ManiacalLabs/Super7Seg/kicad/Super7Controller/Super7Controller.kicad_pcb

## KiCad design kicad/Super7Controller/Super7Controller.kicad_pcb (2017-02-23)

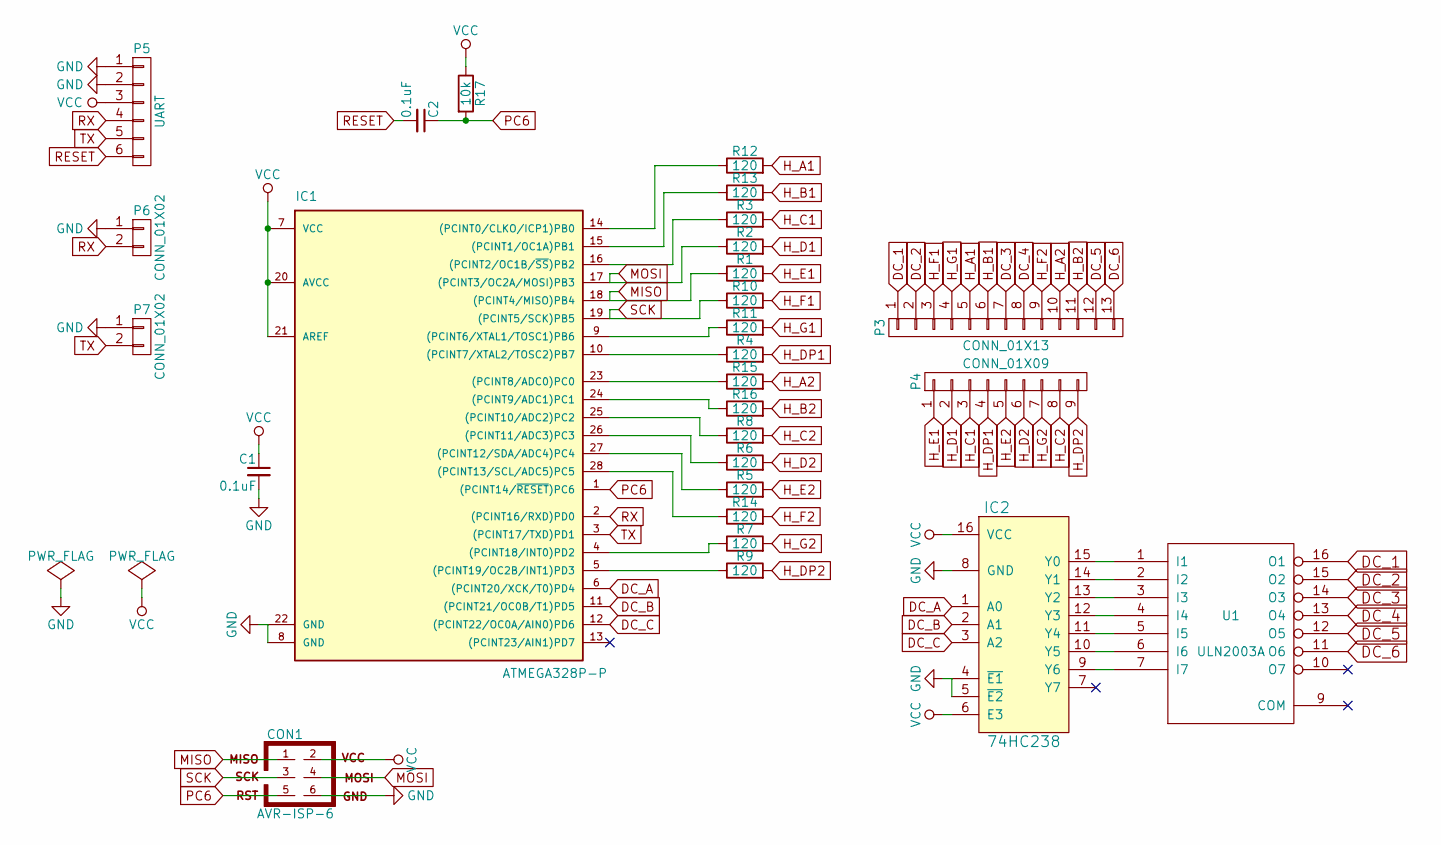
[picture p4: schematic Super7Controller.sch]

Parts:
C1, C2: 0.1uF; C_Disc_D3_P2.5
CON1: AVR-ISP-6; ICSP
IC1: ATMEGA328P-P; DIP28
IC2: 74HC238; DIP-16_W7.62mm
P3: CONN_01X13; Socket_Strip_Straight_1x13
P4: CONN_01X09; Socket_Strip_Straight_1x09
P5: UART; Strip_1x06
P6, P7: CONN_01X02; Strip_1x02
R1, R2, R3, R4, R5, R6, R7, R8, R9, R10, R11, R12, R13, R14, R15, R16: 120; 0.125_Resistor
R17: 10k; 0.125_Resistor
U1: ULN2003A; DIP-16_W7.62mm

Connections:
DC_1: P3.1, U1.16 (O1)
DC_2: P3.2, U1.15 (O2)
DC_3: P3.7, U1.14 (O3)
DC_4: P3.8, U1.13 (O4)
DC_5: P3.12, U1.12 (O5)
DC_6: P3.13, U1.11 (O6)
DC_A: IC1.6 ((PCINT20/XCK/T0)PD4), IC2.1 (A0)
DC_B: IC1.11 ((PCINT21/OC0B/T1)PD5), IC2.2 (A1)
DC_C: IC1.12 ((PCINT22/OC0A/AIN0)PD6), IC2.3 (A2)
GND: C1.2, CON1.6, IC1.8 (GND), IC1.22 (GND), IC2.4 (~E1~), IC2.5 (~E2~), IC2.8 (GND), P5.1, P5.2, P6.1, P7.1, U1.8 (GND)
H_A1: P3.5, R12.2
H_A2: P3.10, R15.2
H_B1: P3.6, R13.2
H_B2: P3.11, R16.2
H_C1: P4.3, R3.2
H_C2: P4.8, R8.2
H_D1: P4.2, R2.2
H_D2: P4.6, R6.2
H_DP1: P4.4, R4.2
H_DP2: P4.9, R9.2
H_E1: P4.1, R1.2
H_E2: P4.5, R5.2
H_F1: P3.3, R10.2
H_F2: P3.9, R14.2
H_G1: P3.4, R11.2
H_G2: P4.7, R7.2
MISO: CON1.1, IC1.18 ((PCINT4/MISO)PB4), R1.1
MOSI: CON1.4, IC1.17 ((PCINT3/OC2A/MOSI)PB3), R2.1
unnamed: IC1.4 ((PCINT18/INT0)PD2), R7.1
unnamed: IC1.5 ((PCINT19/OC2B/INT1)PD3), R9.1
unnamed: IC1.9 ((PCINT6/XTAL1/TOSC1)PB6), R11.1
unnamed: IC1.10 ((PCINT7/XTAL2/TOSC2)PB7), R4.1
unnamed: IC1.14 ((PCINT0/CLKO/ICP1)PB0), R12.1
unnamed: IC1.15 ((PCINT1/OC1A)PB1), R13.1
unnamed: IC1.16 ((PCINT2/OC1B/~SS~)PB2), R3.1
unnamed: IC1.23 ((PCINT8/ADC0)PC0), R15.1
unnamed: IC1.24 ((PCINT9/ADC1)PC1), R16.1
unnamed: IC1.25 ((PCINT10/ADC2)PC2), R8.1
unnamed: IC1.26 ((PCINT11/ADC3)PC3), R6.1
unnamed: IC1.27 ((PCINT12/SDA/ADC4)PC4), R5.1
unnamed: IC1.28 ((PCINT13/SCL/ADC5)PC5), R14.1
unnamed: IC2.9 (Y6), U1.7 (I7)
unnamed: IC2.10 (Y5), U1.6 (I6)
unnamed: IC2.11 (Y4), U1.5 (I5)
unnamed: IC2.12 (Y3), U1.4 (I4)
unnamed: IC2.13 (Y2), U1.3 (I3)
unnamed: IC2.14 (Y1), U1.2 (I2)
unnamed: IC2.15 (Y0), U1.1 (I1)
PC6: C2.1, CON1.5, IC1.1 ((PCINT14/~RESET~)PC6), R17.2
RESET: C2.2, P5.6
RX: IC1.2 ((PCINT16/RXD)PD0), P5.4, P6.2
SCK: CON1.3, IC1.19 ((PCINT5/SCK)PB5), R10.1
TX: IC1.3 ((PCINT17/TXD)PD1), P5.5, P7.2
VCC: C1.1, CON1.2, IC1.7 (VCC), IC1.20 (AVCC), IC1.21 (AREF), IC2.6 (E3), IC2.16 (VCC), P5.3, R17.1

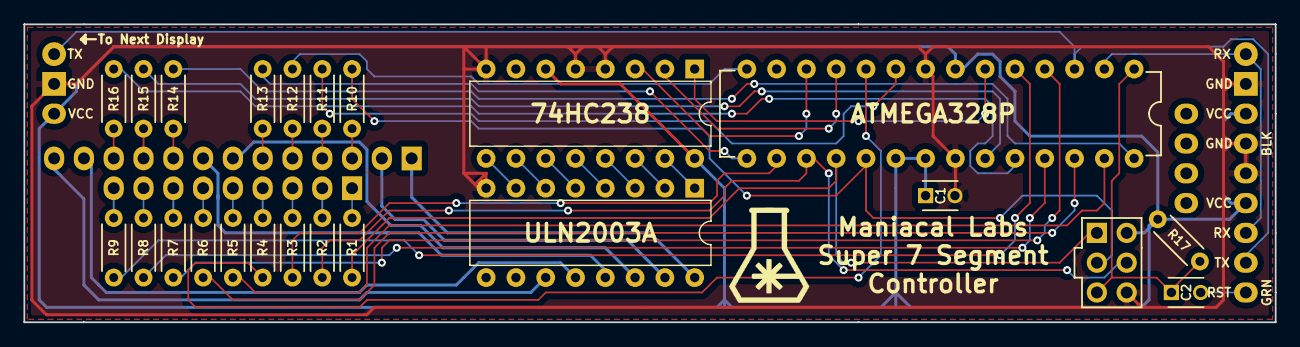
[picture p5: board Super7Controller.kicad_pcb from above]

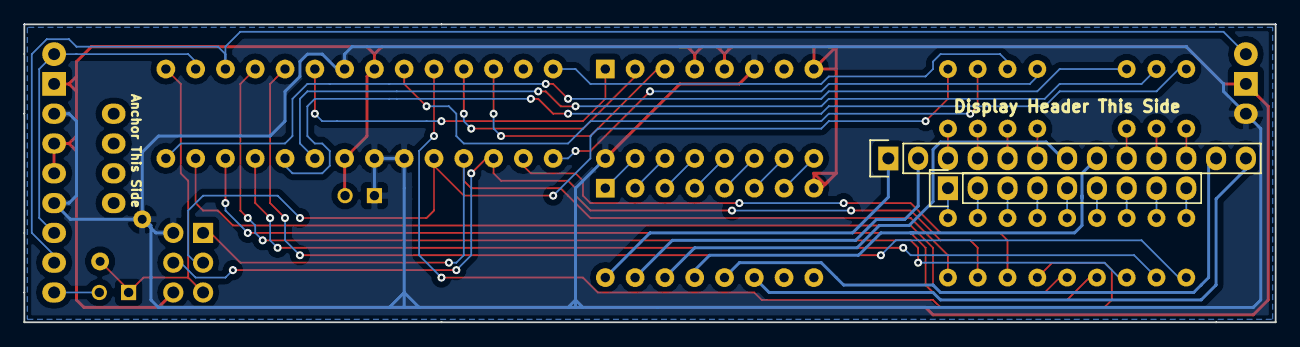
[picture p6: board Super7Controller.kicad_pcb from below]

Board: 2 copper layers, 106.7 x 25.4 mm, 28 parts (2 on the bottom side), 54 nets.
